alkaline3mc/LOBSTER-TRAP/spectrum.jpg

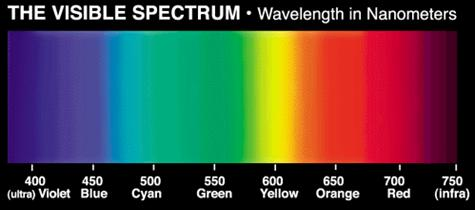
spectrum.jpg
