alkaline3mc/LOBSTER-TRAP/073958photo.jpg

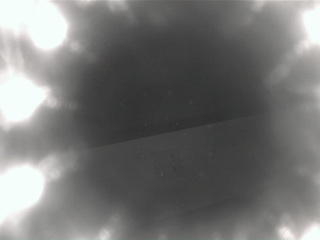
073958photo.jpg
