alkaline3mc/LOBSTER-TRAP/LobsterFinal.docx

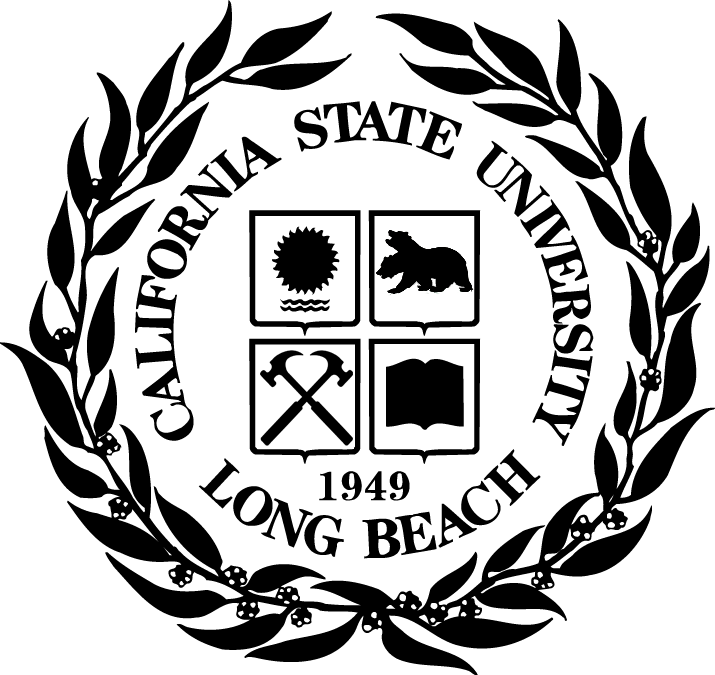
[picture p3: figure]

California State University Long Beach
Computer Engineering Department

CECS 497 Directed Studies Proposal

Mesh Network Remote Underwater Image Acquisition System

Deliverable 1 (Feb. 03, 2015)

Presented By: Matthew Connolly & Brent Scheneman

Under Supervision of John Tramel

# Table of Figures

# Identification and Significance of the Problem or Opportunity

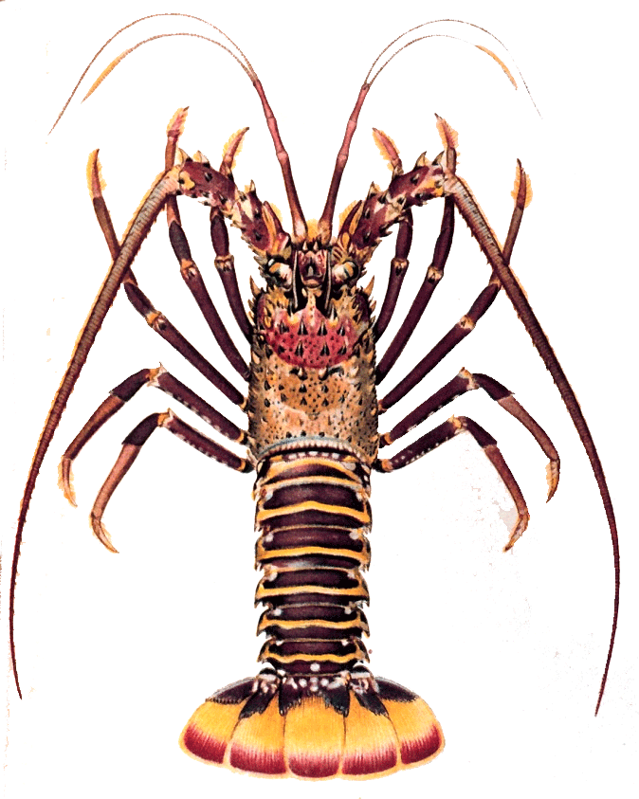
[picture p4: figure]
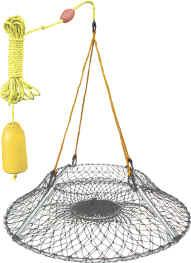
[picture p5: figure]

Figure 0-1: California Spiny Lobster | Figure 0-2 Hoop Net Lobster Trap

The Panulirus Interruptus (California Spiny Lobster) is a highly sought crustacean game that has no claws and dwells within structure during the day. Once the sun starts to set, they venture out into the open ocean to scavenge for food. This is the best time to catch them and for many years, recreational lobster harvesting in California was an activity reserved largely to divers with the skills and bravado to descend into the pitch black ocean and hunt these “Bugs” with their bare hands. Yet within the past seven years, a more productive technique has gained immense popularity — hoop-netting at night. No more night dives. Just drop a baited net (see “Hoop-Netting Gear”), let it soak for 30 minutes, and then pull it up quickly to see if lobsters have crawled inside. Many modern day fishermen who utilize this hoop net approach deploy several nets simultaneously so as to maximize their returns when fishing.

The goal of this project was to create a system which allows a hoop net lobster fisherman to remotely check the contents of multiple traps, reducing unnecessary trap recovery and fuel consumption. The general concept revolves around a modular system wherein each trap is equipped with a waterproofed, infrared camera capable of transmitting data through a serial interface. The cameras are mounted at the apex of the hoop net so as to avoid interfering with the basic operation of the trap while maintaining enough proximity to be able to allow proper imaging of the trap and its contents under normal conditions.

Data from the camera is then transmitted serially to a buoy at the surface of the ocean. These buoys act as nodes in a mesh network, relaying information back to the base collector which is monitored by the user. The base station will allow the user to query one or all of the lobster traps, at their leisure, and to view their contents. In this way, the user does not waste time and energy checking empty traps.

# Phase I Technical Overview

The approach to system development will focus on first achieving function, with future phases dedicated to cost reduction and operation improvement. Key tasks that need to be achieved to ensure proper operation of system are as follows:

## Specifications

- Depth of trap less than or equal to 100 feet.
- System operation does not interfere with normal function of trap
- System allows for tension line that allows trap to stay upright and float to be directly above trap (reduce drift in current)
- Range of 1-3 miles line of sight.
- Battery Operated Buoy
- Base Station Powered by 110V supply (Outlet)
- 1-3 Nodes

## Hardware

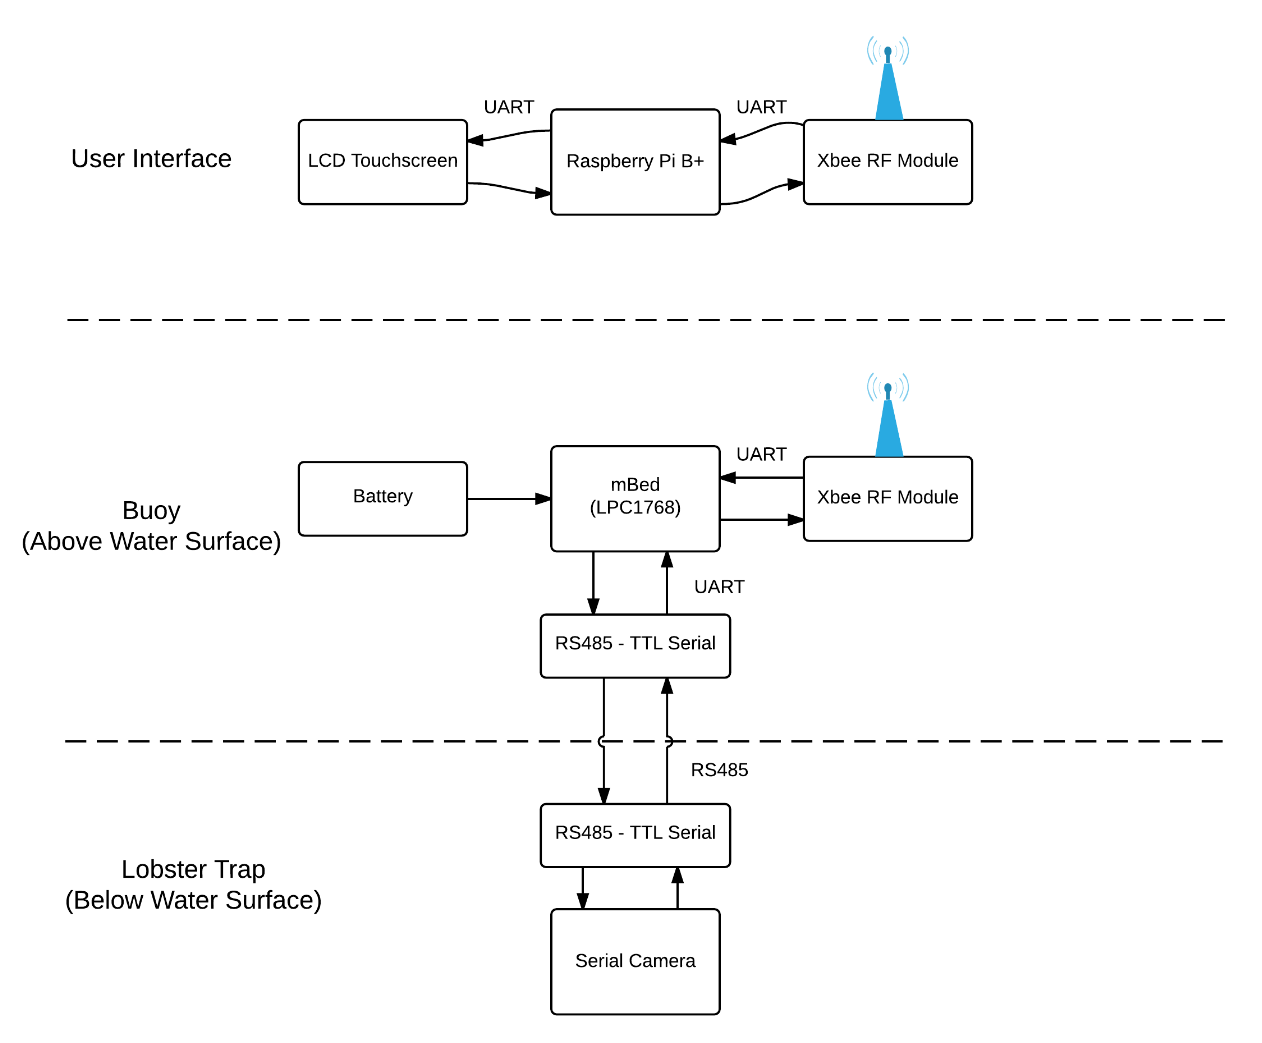
[picture p6: figure]

Figure 0-1 Hardware Block Diagram

### Receiver

### Buoy

#### Buoy Top

#### Buoy Bottom

# Task Listing and Timeline

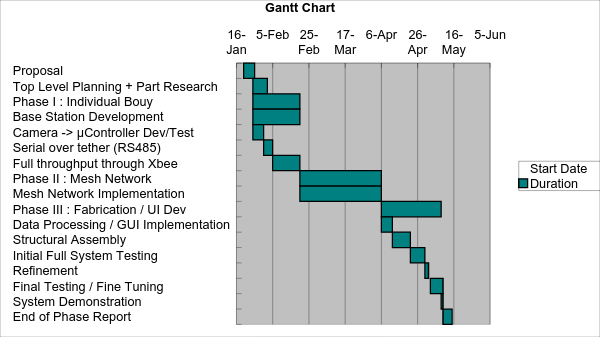
[picture p7: figure]

# Phase I Work Plan

## Statement of Work

Generally, this project will be broken down into three main phases; the initial phase will be dedicated to establishing an individual buoy system proof of concept. The goal of this single node approach is to first validate the fundamental concept and to glean information about data transfer rates, and basic process flow. This step will also help to identify any issues regarding power supplies or other electronic factors that will need to be addressed early on such as noise generated by processors interfering with RF communications. Testing in this phase will also reveal the capabilities of low light imaging in an underwater environment, which will be a topic that will pervade the entire timeline of development and will need constant enhancement.

The second phase will target implementing multiple buoys into the system. The development of the requisite mesh network needed to implement this approach effectively will occupy the bulk of the work throughout this project. A wireless mesh network (WMN) is a communications network made up of radio nodes organized in a mesh topology wherein all nodes cooperate in the distribution of data in the network. Our team’s experience with this technology is limited and will produce an excellent learning opportunity for us, as well as to enhance the challenges of development. Due to the nature of the project, the mesh network is the most ideal for our application.

Phase 3 of our project will be dedicated to testing, UI enhancement, and system refinement as well as waterproofing and enclosure design. Much of this phase will focus less on theory and research, and more on technical work and fabrication.

A series of deliverables will be provided to our project supervisor John Tramel. In keeping with the phased structure of our project, the culmination of each phase will demand working deliverables of the tasks said phases were dedicated to. As such the following deliverables will be provided:

## Schedule

## Deliverables

### Task Deliverables Responsibility Schedule

Task | Team Member(s) Responsible | Specifications / Extended Description | Date
| Phase I
Software Flowchart | Matt | Provide a software flowchart illustrating the conceptual activities performed by the base station and highlighting potential tools necessary to implement these tasks. | 02/03/2015
Top Level Hardware Block Diagram | Brent | Provide a top level hardware block diagram for the project citing specifically researched components and their implementation with relation to the project | 02/03/2015
Serial Camera Test | Matt | Demonstrate the ability to command target camera to produce an image capture and output it into a microcontroller via serial connectivity. | 02/10/2015
Long Distance Serial | Matt | Demonstrate the previous task, now over some form of long range serial medium (>30ft). | 02/17/2015
Base Station | Matt | Demonstrate Base station initial framework including controller and display. | 02/24/2015
| Phase II:
Single Node Connectivity | Matt and Brent | Demonstrate transmission of simple text between a base and a single node using wireless data transfer methods. | 03/03/2015
Single Node Image | Matt and Brent | Demonstrate transmission of image upon query from base station, from node to base station. | 03/10/2015
Multiple Node Connectivity | Matt and Brent | Demonstrate transmission of simple text to and from multiple nodes across a mesh network containing a minimum of three nodes. | 03/17/2015
Multiple Node Image | Matt and Brent | Demonstrate transmission of simple text to and from multiple nodes across a mesh network containing a minimum of three nodes. | 03/24/2015
| Phase III:
GUI | Brent | Demonstrate GUI that will be implemented in the final system. GUI will allow user to query an individual node or the entire net, and will be able to display the images from one or more of the nodes | 04/12/2015
Individual Complete Buoy | Matt | Present a completely functional individual buoy featuring independent power supply (batteries / solar / etc), proper buoyancy characteristics and nodal function. | 04/12/2015
Project Final Demonstration | Matt and Brent | Demonstration of complete working project, including GUI implemented base station capable of querying all or individual network nodes and displaying images of the contents of the traps at each node. Trap and buoy nodes will be self powered, trap will be submersible to 100 feet maximum depth. | 05/10/2015
End of Phase Report | Matt and Brent | Submit Complete Documentation of project outlining all major tasks, completion and lessons learned. | 05/15/2015

# Prototyping

In an effort to mitigate risk and to develop a proof of concept, an initial prototype model was designed and fabricated. The process followed is outlined in the following section and includes a full detailing of the lessons learned and successes achieved during the process.

## JPEG Serial Camera

Initial plans to create the camera module focused on the use of a weatherproof TTL Serial JPEG Camera with NTSC Video and IR LEDs. The choice to utilize this camera was based entirely on its ease of implementation. Very little effort was required to waterproof this camera and to implement it in early testing. Initial testing utilizing the camera, a Raspberry Pi and a Python module allowed us to grab some sample images.

In order to verify the camera module’s operation it was first tested as a simple camera feed. The next step was to test the serial camera snapshot features of this module. As the end terminal in this implementation was ti be the Raspberry Pi B+, it was the platform utilized during this test. The camera was wired to the Pi using the following matrix:

- Red to +5v Supply
- Black to Ground
- Green is Serial RX and was connected to the Pi Serial TX
- White is Serial TX and was connected to the Pi Serial RX
- Yellow and Brown were left unconnected as they are video dedicated

At this point the Serial Camera on the Pi had to be unlocked. This was accomplished using the method listed in the appendix.

From the beginning of the project we had anticipated using IR LED lighting to light the subjects so as to not disturb the prey . In retrospect IR light is not ideal for this application as the red range of the color spectrum is the first to drop off in water. Infrared having an even higher wavelength value than red light makes it not an ideal lighting source for deep water imaging.


0-1Color Spectrum, Infrared displays higher wavelenght than red which is weakest color for underwater lighting

In order to completely waterproof the camer for operation at depth it was decided to encase the already weatherproof camera in a reinforced casing and pot it with resin. In order to ensure the lens would be waterproof a second acrylic shield was added to the casing which was constructed of a 2” PVC coupler. The unintended effect of adding this secondary lens was that the IR lights which were designed to illuminate the subject were reflected back into the camera. This error would be rectified in the phase II implementation. The waterproofing solution functioned as anticipated and laid the groundwork for other waterproofing solutions in future projects.

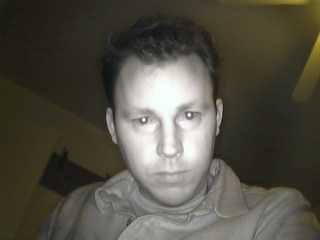
[picture p8: figure]

0-2Sample Image From Initial JPEG Serial Camera Test

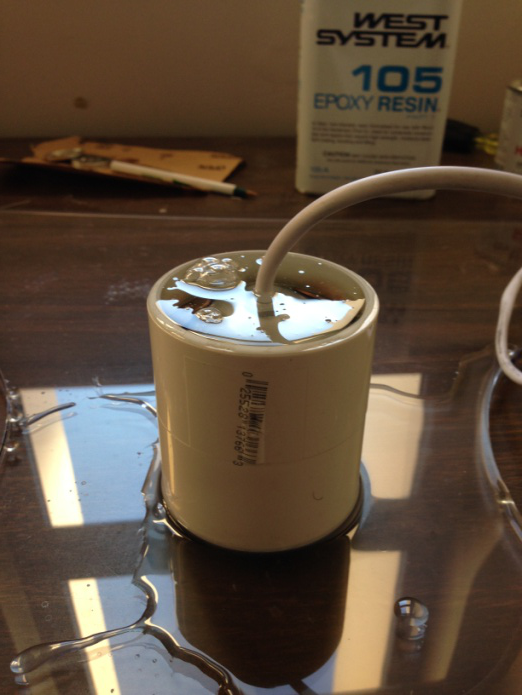
[picture p9: figure]
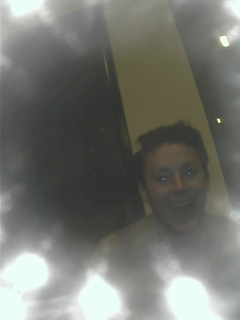
[picture p10: figure]

0-3 Potted Serial Camera and Sample Image

## RS485

Due to the availability of conductors in the tether we elected to use it was determined that using a full duplex Serial configuration for our RS485 implementation would be ideal as it would allow for a hardware heavy and fast proof of concept test. Initial testing of the RS-485 configuration involved basic serial communication back and forth between a microcontroller (mBed LPC1768) and a terminal module. This implementation was tested at 100’ of cable and proved effective at transmitting basic serial messages. Following this test the circuit was arranged for prototyping phase I.

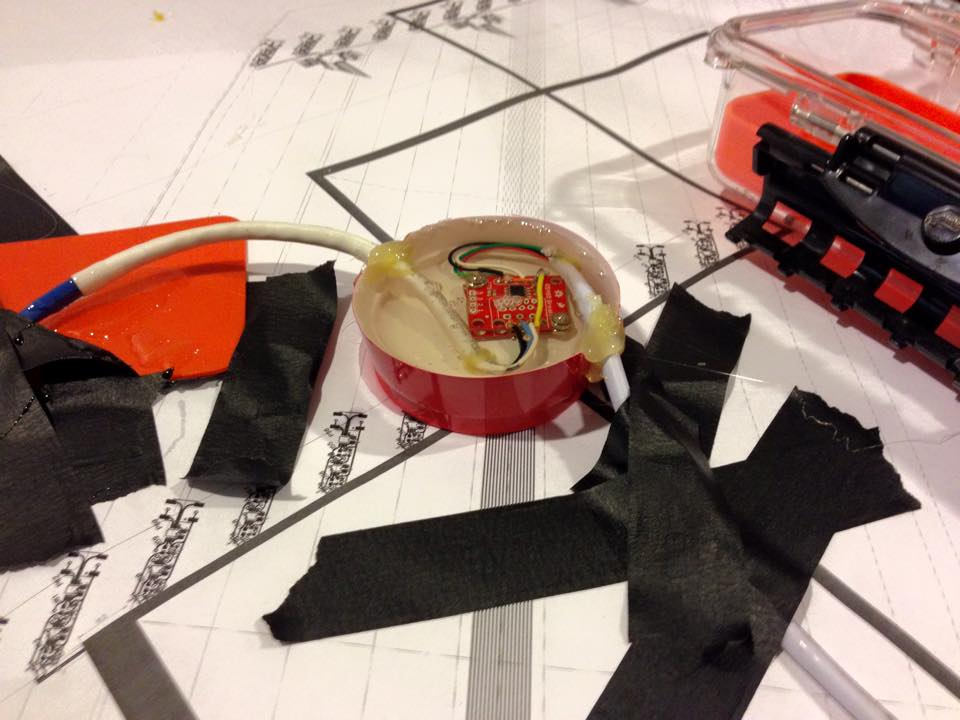
[picture p11: figure]

0-4Potting the RS-485 Puck

In order to waterproof the RS-485 puck resin was once again utilized. The circuit was wired utilizing two RS-485 breakout boards in full duplex configuration. A solo cup cut at its base was used as a cast for the resin potting. This created a puck that housed the electronics and precluded them from being exposed to water. On te topside circuit the RS-485 was wired in a similar fashion however since the electronics are all contained in a waterproof case there was no potting required. Resin potting required 24 hours to cure.

## Assembled Prototype

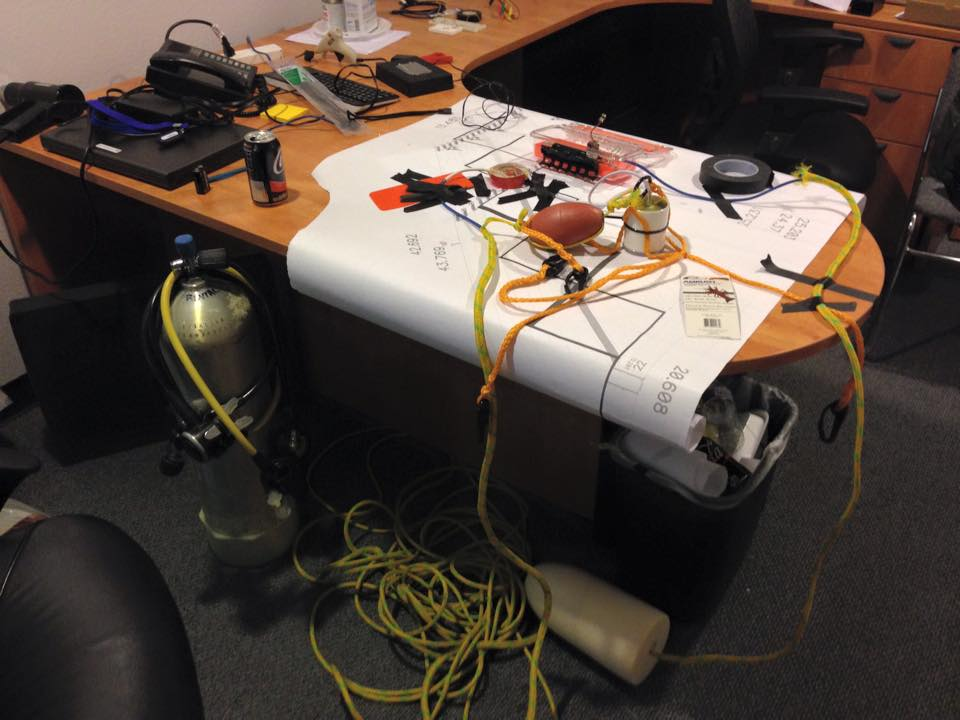
[picture p12: figure]
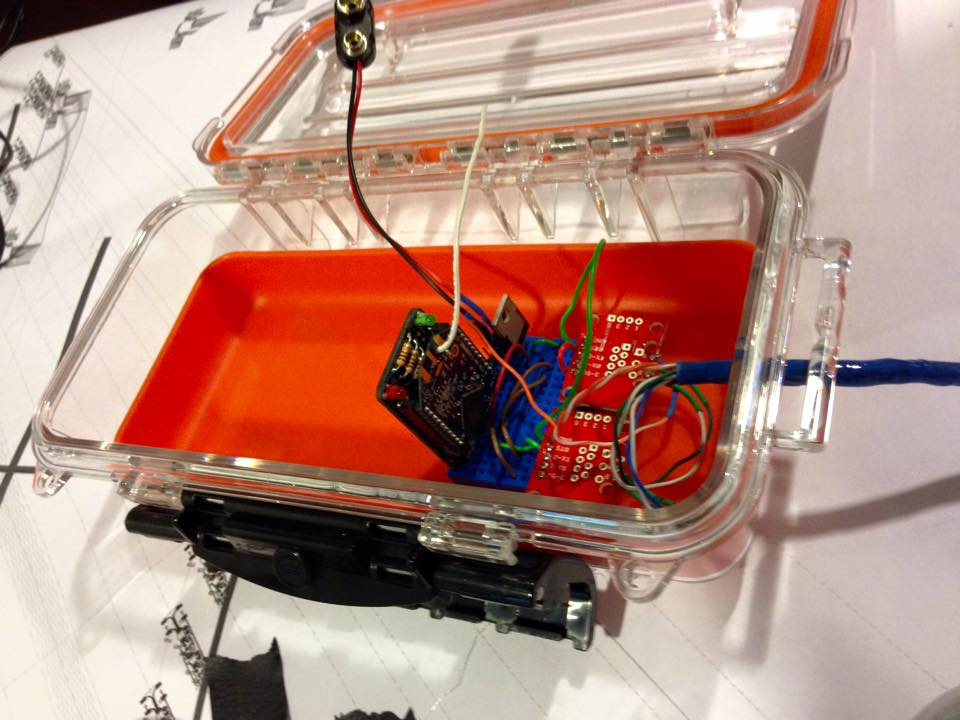
[picture p13: figure]

The final assembly of the prototype was conducted the night before initial testing. Simplicity was favored in the interest of being able to easily observe

## Control Module

The control module comprised of a Raspberry Pi B+ with a touch screen and an Xbee transmitter/receiver module.

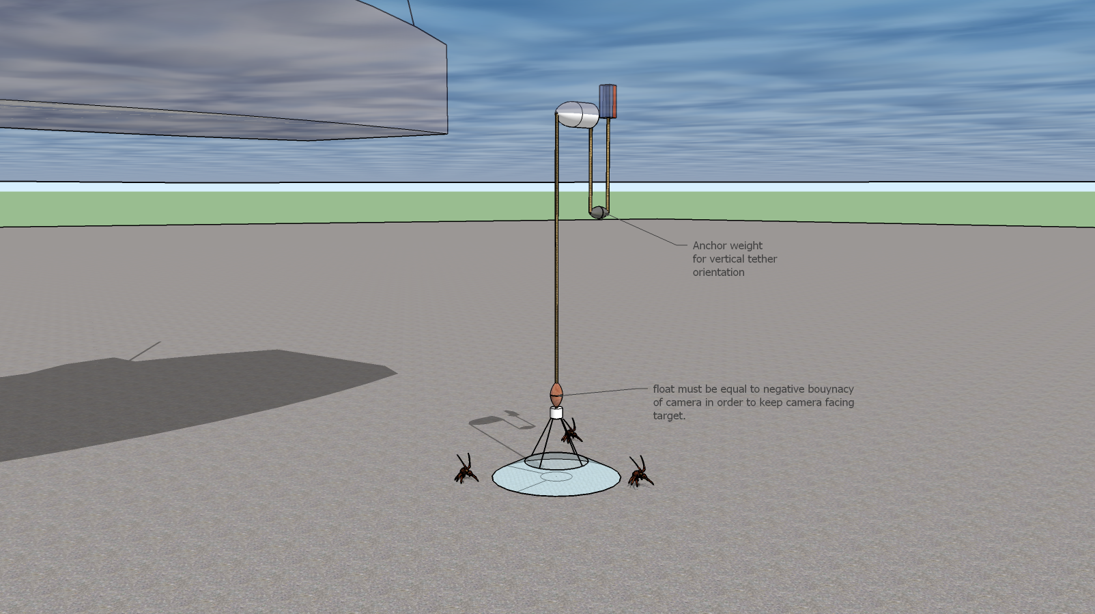
[picture p14: figure]

0-5Phase II Implementation Concept

# Phase II Implementation

Many lessons were learned during the initial fielding of the prototype system. In the phase II development period we made every attempt to address these issues so as to make a more viable product.

## Buoy

From the earliest stages of development of the prototype system there was concern about how the tether would function mechanically. Having a long tether which would not be retracted seemed like an invitation to have the topside buoy drift very far off target. The interest in keeping the tether vertically aligned is the system’s dependence on this configuration for keeping the camera module trained on the subject area. During testing there were some instances wherein the current and the long tether length caused the camera to drift off of the target area. In order to rectify this the above pictured solution was implemented which uses a counterweight on the line to keep the tether taught over the target area. This not only improves the effectiveness of the camera, it also reduces recovery time which is when the subject is most likely to be able to escape.

## Buoy

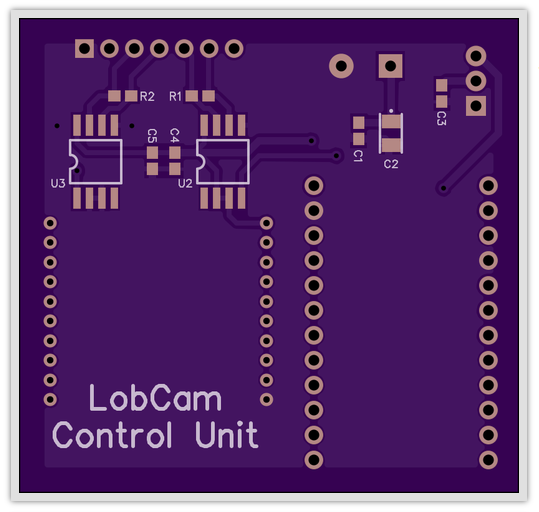
[picture p15: figure]
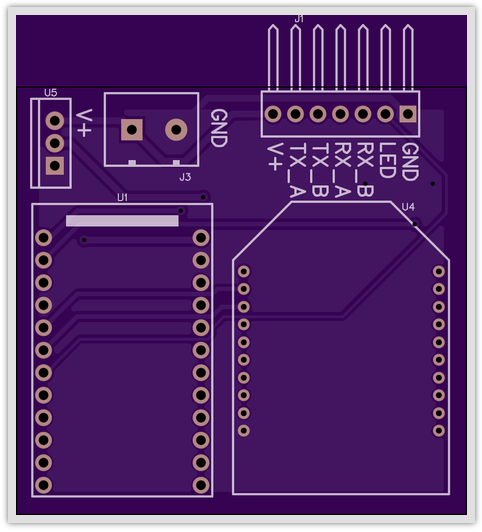
[picture p16: figure]

0-1Buoy Circuit Board Layout

The Buoy for the phase II version of the lobster trap implements all the hardware of the phase I design, with the addition of a microntronctoller, for ease of implementation of the MESH network an Arduino Pro Mini was used. The same voltage regulation was utilized as was used in phase I. Similar to the phase I module, heat dissipation is handled by the braided wire fed to the exterior bolt on the housing.

## Camera Module

Given the lessons learned from the original implementation many adjustments were made to the phase 2 camera module. First and foremost, the camera module is a redesigned circuit board with lower weight and footprint. Originally LED strips were targeted for use in development, however due to desires for a constrained footprint the use of individual LED was elected for. This allowed the overall radius of the board to be reduced as the footprint of the LED could be manually manipulated and brought in closer to the center of the board. A 2 layer board was implemented with components placed on both sides. The board design is potted on one side with Resin (The backside without the optics and lighting). The potting is filled in only enough to waterproof the electronics while allowing the heat sinks of the various voltage regulators and the N-Channel Mosfet to be exposed to the water. This will allow for enhanced cooling capabilities of the system.

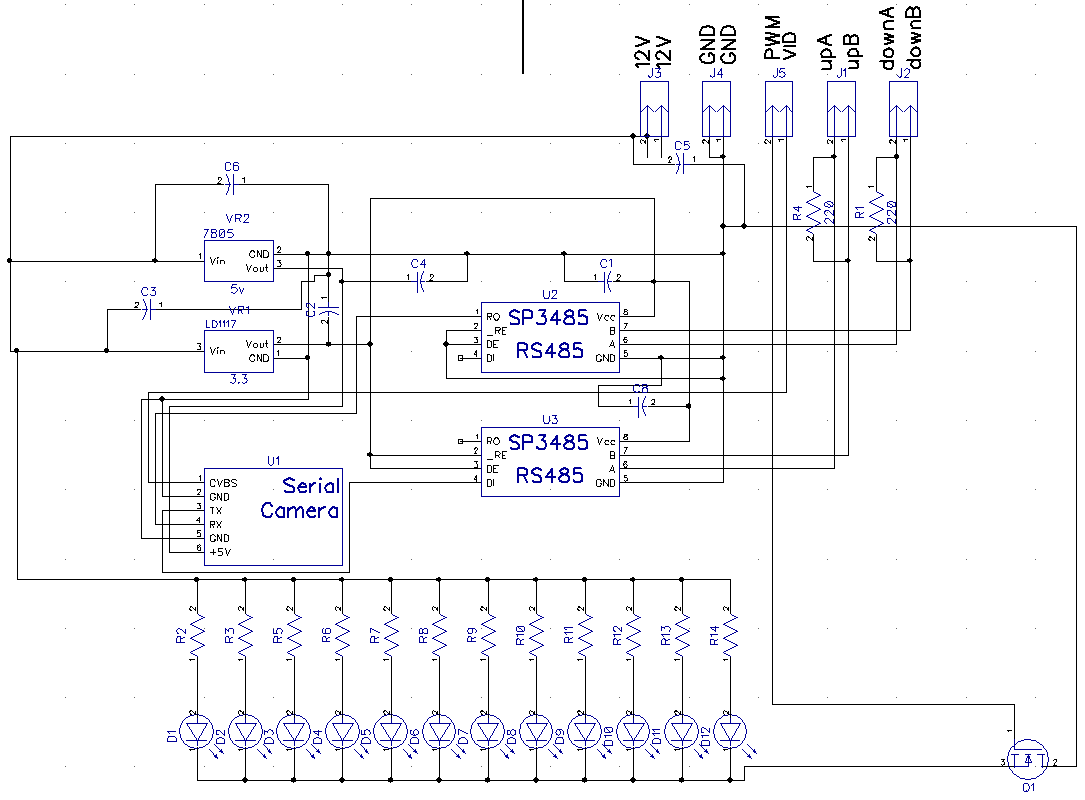
[picture p17: figure]

0-2Final Lobster Cam Schematic

The goal of the phase II camera is to allow ful control of the lighting in an effort to create a more natural lighting surge and to reduce power consumption. The original camer module’s lighting was constantly on and served to drain the battery at too high a rate. This model utilizes an N-Channel MOSFET (5863) and a PWM signal generated by the surface microcontroller to activate the lighting at a slow surge at the moment the camera needs to take a picture.

In keeping with the lessons learned in the first phase of the project, the RS485 module is powered with the appropriate 3.3v supply. Additionally the camera lens will be flush with the protective screen. For the phase II implementation a 10 conductor wire was selected to allow for power supply to be produced to the camera module.

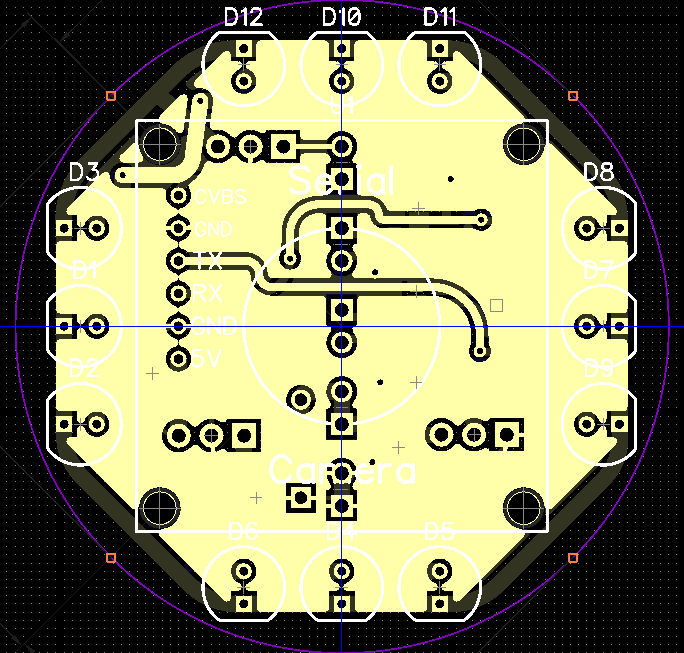
[picture p18: figure]
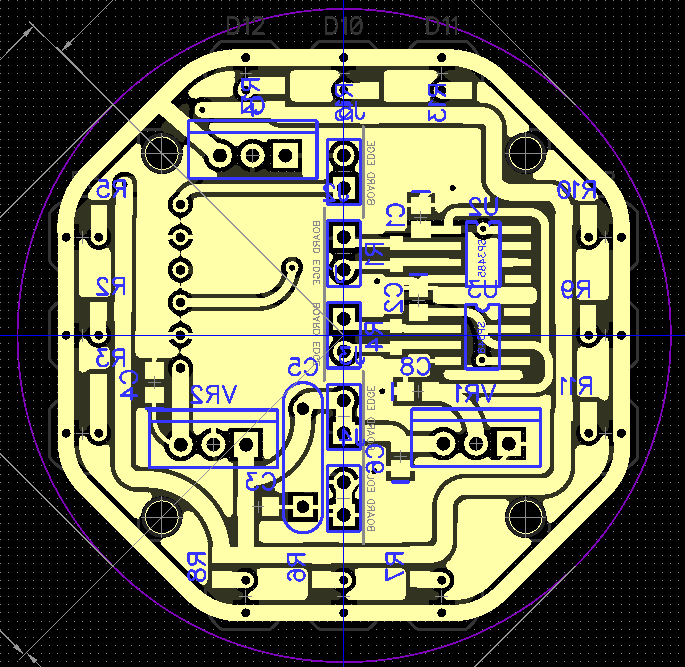
[picture p19: figure]

0-3Phase II PCB Camera Board Footprint Top and Bottom

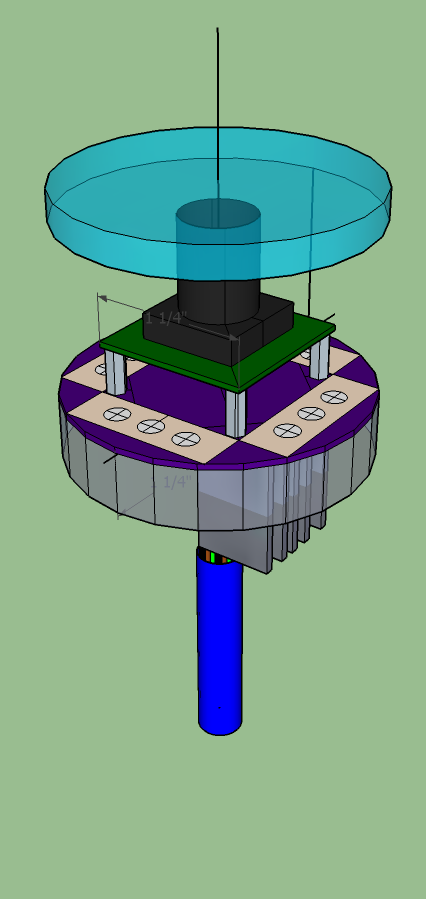
[picture p20: figure]
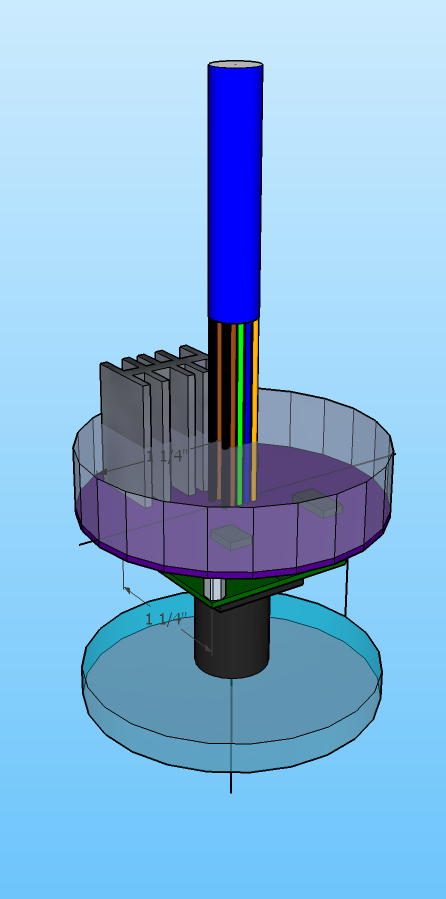
[picture p21: figure]

0-4Phase 2 Lobster Cam Concept Sketch

# Related Work

To date, our team has had sufficient success implementing related projects to this one. We have already addressed long range serial communication using RS485 in the development of an underwater ROV, “Xeebo” during the summer of 2014. “Xeebo” demonstrated our ability to effectively transmit data to and from a remote point utilizing RS485 in a half duplex configuration. In addition, there was much learned regarding effective waterproofing, heat dissipation in a closed system environment, and tether design / power considerations utilizing a tethered system during this project. Buoyancy was also addressed heavily throughout “Xeebo” which may also have implications in this project.

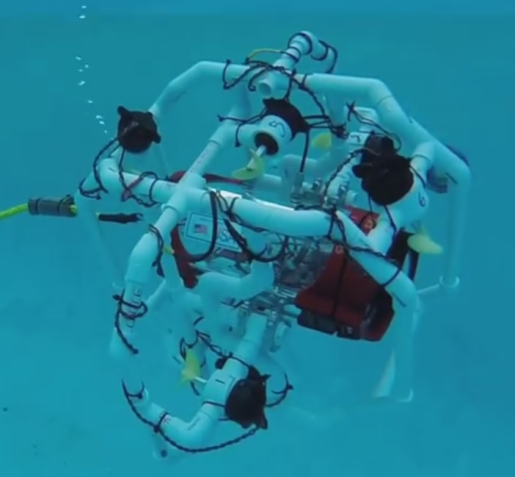
[picture p22: figure]

Figure 0-1 "Xeebo" Remote Operated ROV

Some cursory exploration into the use of RF data transmission was completed under the “OPS” heads up tactical display system conducted by the team. This project aims to pick up where that project left off in terms of use of the Xbee RF data transmission. “OPS” was only ever capable of data transmission between two nodes. With this lobster trap system, the very nature of the project requires that multiple nodes be able to interact and chain their transmissions along a mesh network. This will allow for a more dynamic implementation as well as serve to increase the maximum range of the entire system.

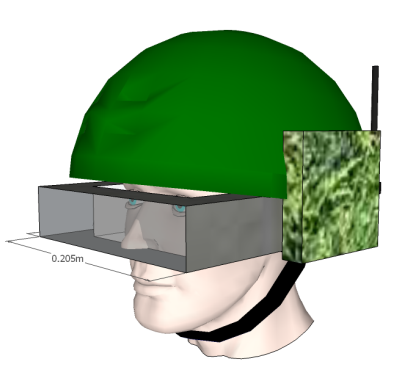
[picture p23: figure]

Figure 0-2 OPS Battlefield Awareness System

# Commercialization Strategy

In an effort to make this the foundation for a commercially viable undertaking, care will be taken to minimize cost while still not sacrificing performance. Care in leveraging the capabilities of the mesh network, as well as thorough part selection and design will be taken in order to result in an end product that is functional and robust, while also leaving an infrastructure for future development and enhancement. Initial proof of concept incarnations will favor simplicity of implementation in an effort to refine crucial software and electrical hardware systems. Once those systems are complete, efforts to refine and enhance the physical design will be undertaken.

# Key Personnel

Mr. Scheneman brings to this project experience in embedded systems, electronic hardware design, complete system on chip design flow, and remote data acquisition development.

He has been part of a team of engineers who developed the next generation of inert atmosphere gloveboxes and inert gas purification systems at Vacuum Atmospheres Co. located in Hawthorne, CA. Mr. Scheneman contributed to the industrial automation and control system design on a multitude of purification systems, along with the mechanical design of innovative inert gas purification systems.

He has extensive involvement in complete embedded system development from low-level sub-system design to high-level system integration. This is made possible with his experience in embedded processor applications involving communication and control of external peripheral devices. This includes communication with wireless sensor networks using industry standard self-healing mesh network protocols. Additional experience includes System on Chip (SoC) design implemented on Field Programmable Gate Array (FPGA) utilizing hardware description languages such as Verilog and VHDL.

After joining M4 Engineering, he has contributed heavily to the design and implementation of remote rugged data acquisition systems for condition monitoring applications that require the upmost in durability and reliability. This involved top-down design of hardware systems and firmware, coupled with web-based methods for displaying and analyzing the acquired data. Mr. Scheneman has contributed to the development of high performance cloud computing systems responsible for high-speed computational fluid dynamic analysis and simulation.

Mr. Connolly supplies the project with experience in embedded system development implementing top-down methods for hardware/software system-on-chip (SOC) co-design.

His most recent involvement with M4 saw him contribute heavily to the design and implementation of an innovative, large scale, and high throughput real-time data acquisition project designed for the NASA Langley research center in Langley VA. This work focused on creating a robust embedded system capable of high volumes of simultaneous data acquisition while also working to simplify connectivity requirements for existing systems. The scope of the project also required the validation of hardware components through experiment and analysis.

Other projects he has been involved in have focused on myriad aspects of embedded system development ranging from complete system, to task specific subsystem development. His experience includes implementing sequential logic emphasizing finite state machine design & analysis, and timing analysis of sequential logic.

Additional experience includes the use of Electronic Design Automation (EDA) tools for design, simulation, and verification of logic circuits as well as circuit board design and fabrication. He has implemented embedded systems using Field Programmable Gate Array (FPGA) and microcontroller processing architectures using complete SOC design flow from specification to working SOC. Additionally he has worked on the creation of Register Transfer Level (RTL) modules designed for reuse and integration of intellectual property (IP) for RTL and physical level IP, IC verification, and creation of self-checking test benches for designs.

His diverse skill-set and experience derived from his prior service in Special Operations Command (SOCOM) as a member of a small technical surveillance and long range reconnaissance team affords him unique insight as to real world implementation of military systems in harsh environments and end user expectations. Following his military service he attended California State University; Long Beach where he led the team responsible for pioneering the schools underwater robotics program, as well as developed experimental reality augmentation embedded systems for military applications.

# Facilities / Equipment

Lab space provided by the CSULB Engineering department will serve as a base of operations for the lobster trap project. Initial testing will be conducted in one of the school’s three pools through coordination with faculty. Full system testing will be conducted out in the ocean through personal contacts and interested parties that have boat access, as well as at local public ocean access points such as La Jolla Cove / Long Beach Marina.

Traps and requisite equipment will be provided by the team as needed.

# Consultants

- John Tramel

Mr. John Tramel will serve as the project overseer and advisor. The team will report all status and deliverables to him. Additionally, his expertise in embedded system development will be sought throughout development in order to streamline production and to circumvent common pitfalls amongst inexperienced engineers.

- Bob Ward

Mr. Ward will be consulted regarding electrical systems design and as a consulate to exterior interested parties. His knowledge regarding underwater systems will be sought as well.

# References Bibliography

"California Lobster Battles." Boating Magazine. N.p., n.d. Web. 26 Jan. 2015.

"Mesh Networking." Wikipedia. Wikimedia Foundation, n.d. Web. 26 Jan. 2015.

"California Spiny Lobster." Wikipedia. Wikimedia Foundation, n.d. Web. 26 Jan. 2015.

# Implementation and Results

# Conclusions

# Appendix
