alkaline3mc/LOBSTER-TRAP/073620photo.jpg

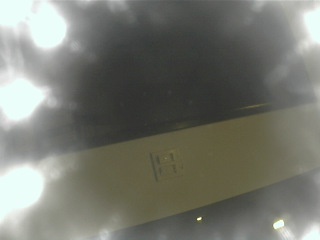
073620photo.jpg
