alkaline3mc/LOBSTER-TRAP/073635photo.jpg

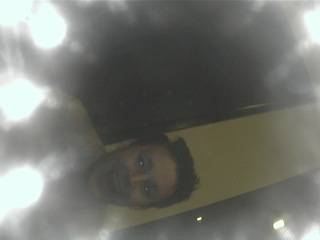
073635photo.jpg
