alkaline3mc/LOBSTER-TRAP/073648photo.jpg

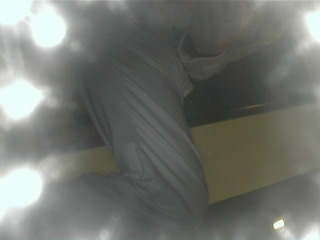
073648photo.jpg
