alkaline3mc/LOBSTER-TRAP/074010photo.jpg

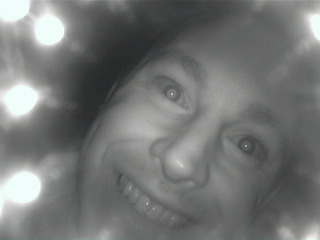
074010photo.jpg
