alkaline3mc/LOBSTER-TRAP/093931photo.jpg

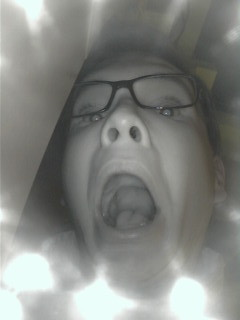
093931photo.jpg
