alkaline3mc/LOBSTER-TRAP/11018826_10203722940809894_870968847293606640_n.jpg

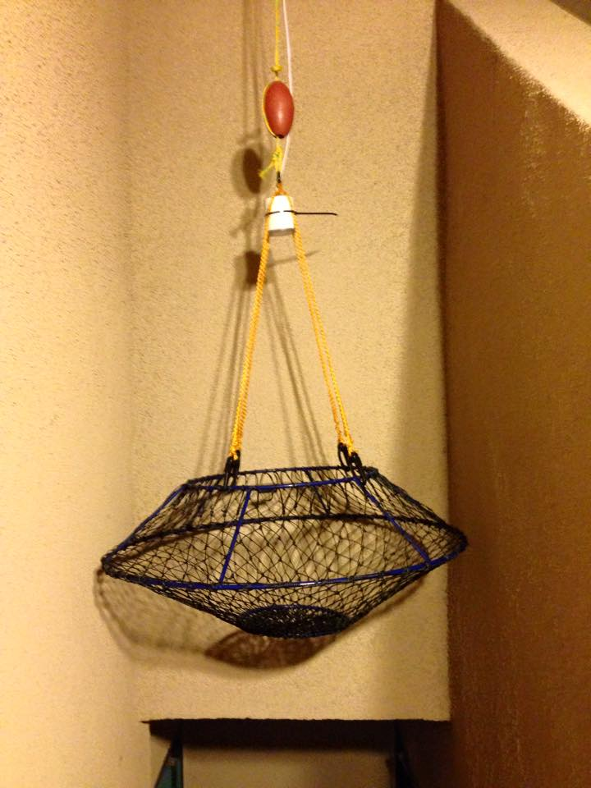
11018826_10203722940809894_870968847293606640_n.jpg
