alkaline3mc/LOBSTER-TRAP/11043075_10203722940489886_5988465612864862919_n.jpg

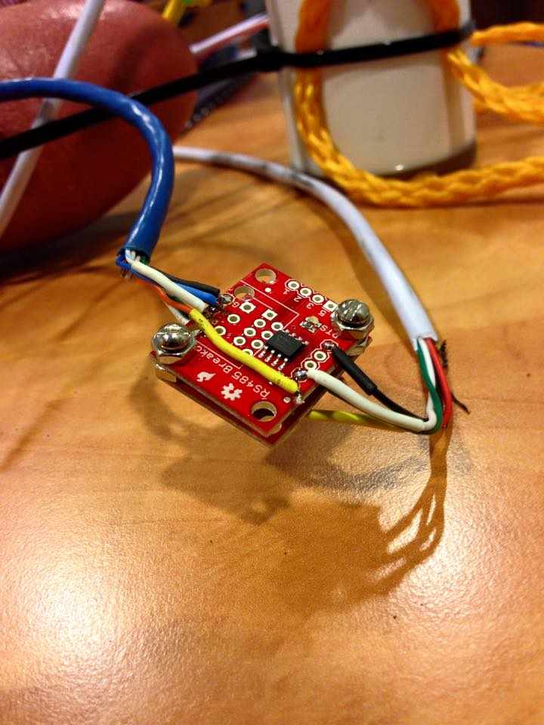
11043075_10203722940489886_5988465612864862919_n.jpg
