alkaline3mc/LOBSTER-TRAP/Camera Mockup 2.png

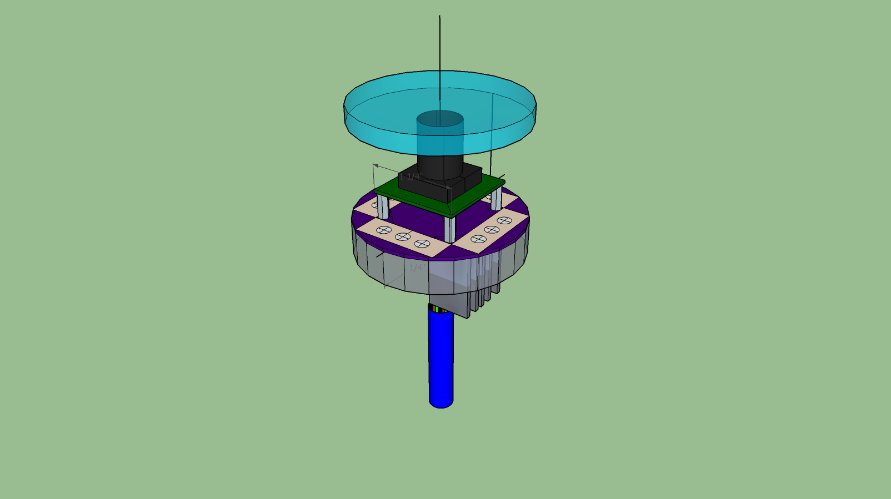
Camera Mockup 2.png
