alkaline3mc/LOBSTER-TRAP/Camera Mockup.png

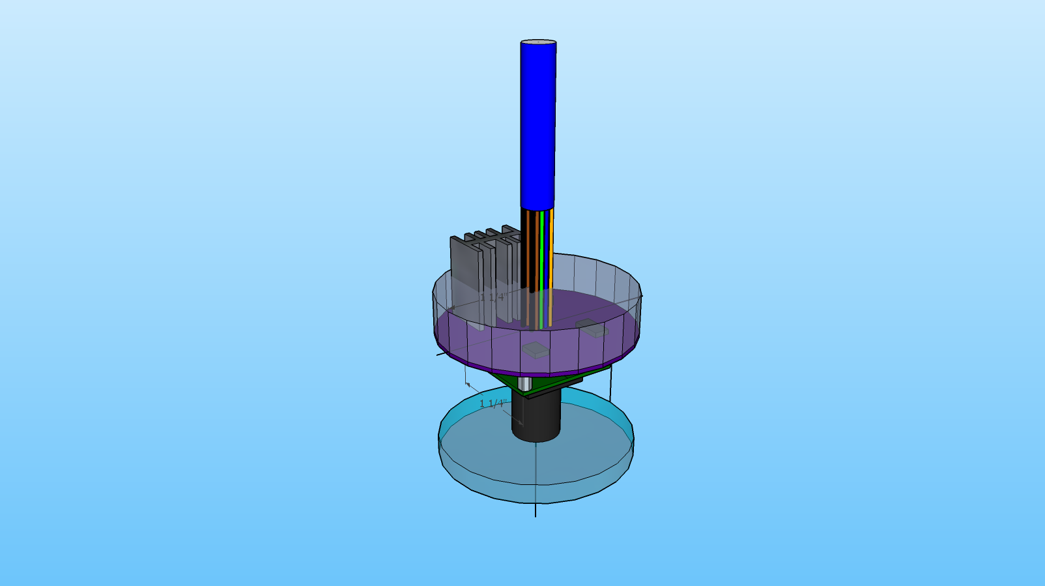
Camera Mockup.png
