alkaline3mc/LOBSTER-TRAP/IMG_3528.JPG

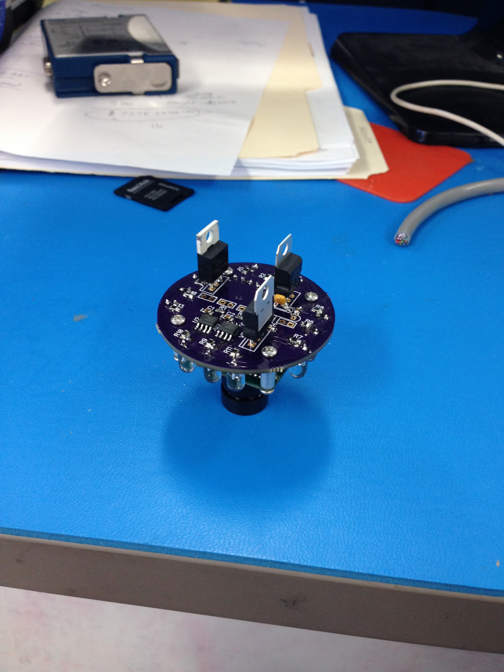
IMG_3528.JPG
