alkaline3mc/LOBSTER-TRAP/IMG_3529.JPG

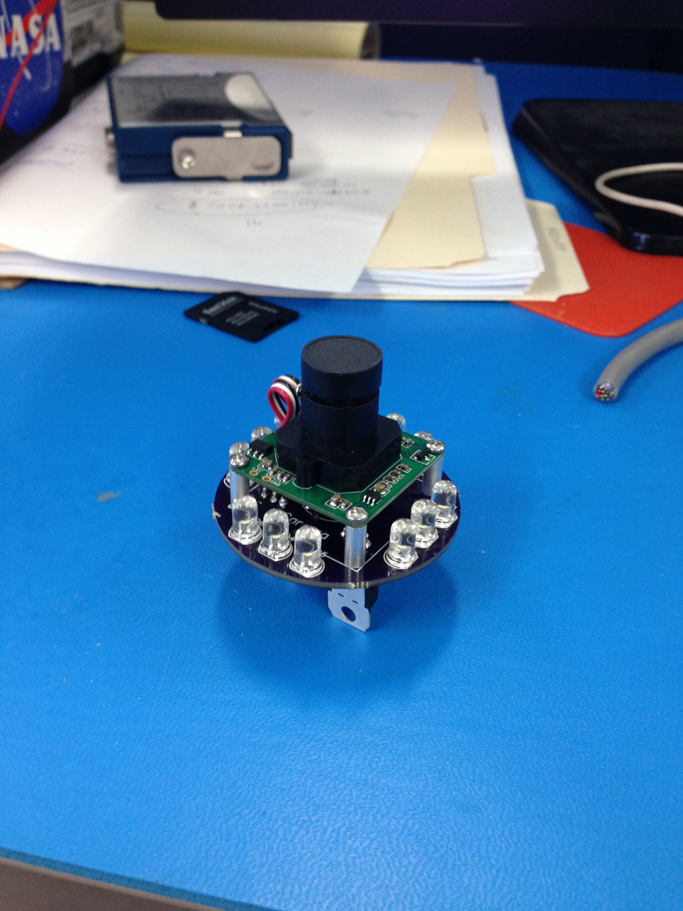
IMG_3529.JPG
