alkaline3mc/LOBSTER-TRAP/IMG_3530.JPG

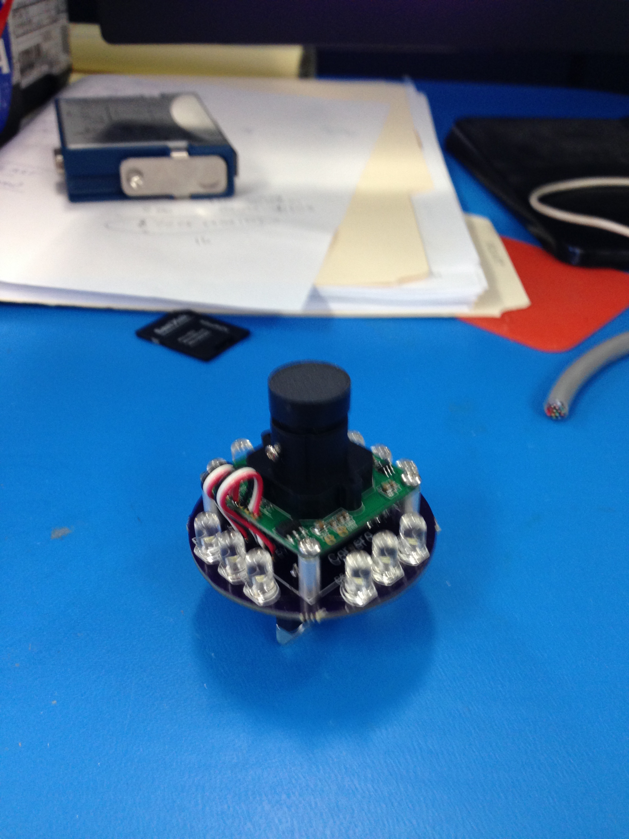
IMG_3530.JPG
