alkaline3mc/LOBSTER-TRAP/IMG_3531.JPG

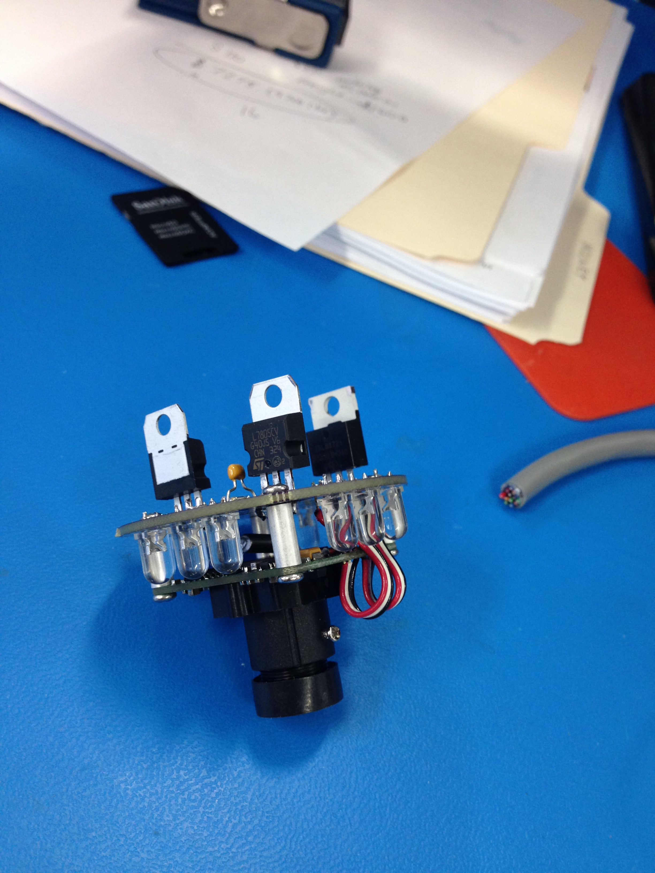
IMG_3531.JPG
