alkaline3mc/LOBSTER-TRAP/Top Level Model.png

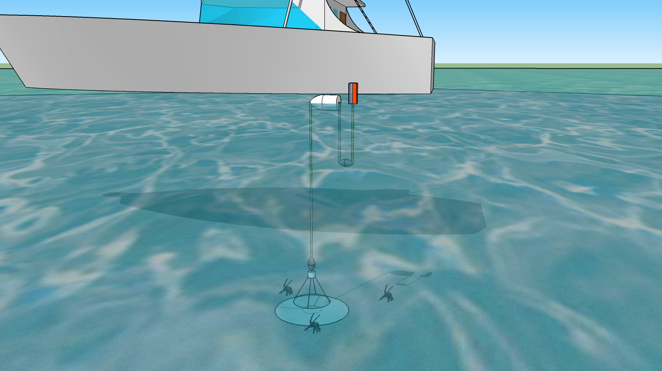
Top Level Model.png
