alkaline3mc/LOBSTER-TRAP/(list of files, cad)

Other CAD files:
Camera Mockup.skp
Top Level Model.skp
