alkaline3mc/LOBSTER-TRAP/(list of files, drawings)

Other design files:
Buoy.dch
Buoy.dip
Camera.dch
CameraBoard.dch
LOB2.dch
LOB3.dch
Lob3.dip
LOB4_indLED.dch
LOB4_indLED.dip
Lob.dip
