alkaline3mc/LOBSTER-TRAP/(commit log)

2015-05-15 Medi Dump
    Dropped in all the relevant files, they are not organized... not one bit
    [Camera Mockup.skp, Camera.dch, CameraBoard.dch, LOB2.dch, LOB3.dch, LOB4_indLED.dch, LOB4_indLED.dip, Lob.dip]
2015-05-15 Added LobCam Control Unit Board Renderings
2015-05-15 Added LobCam DipTrace Files
    [Buoy.dch, Buoy.dip]
2015-06-04 Stuff
    And things
    [LOB4_indLED.dch, LOB4_indLED.dip]
